ISMR-Labs/Sinhala-Speech-to-Haptic-System-for-the-Hearing-Impaired/media/README.md

# Media

## photos/2026-09-24-vibration-array

The first hardware build: 17 vibration-motor modules in printed pods on 1 m sleeved leads, the
push-button controller box, and the chase test with the ESP32-S3 lighting each module in turn.
EXIF removed, long edge 1600 px.

| | |
|---|---|
| `IMG_7158` | printed pods and lids fresh off the printer |
| `IMG_7161` to `IMG_7163` | the harness: 17 pods on braided leads |
| `IMG_7171` to `IMG_7178` | controller box with the push button, modules laid out |
| `IMG_7180` to `IMG_7184` | module close-ups and the full set |

## video

Videos are attached to the GitHub release `hardware-2026-09-24` to keep the repository small;
poster frames are kept here.

| File | Length | Contents |
|---|---|---|
| `vibration-array-demo-2026-09-24.mp4` | 24 s | chase test: modules buzzing one after another |
| `vibration-array-modules-2026-09-24.mp4` | 8 s | close-up of the pods and leads |
