ISMR-Labs/Sinhala-Speech-to-Haptic-System-for-the-Hearing-Impaired/paper/haptic-vest.pdf

# A Word-Level Vibrotactile Vest for Delivering Spoken Sinhala to Deaf Users: Design, Encoding and Evaluation Protocol

Dilan Perera
Intelligent Systems & Mechatronics Research Laboratory (ISMR Labs) Colombo, Sri Lanka
https://github.com/ISMR-Labs/Sinhala-Speech-to-Haptic-System-for-the-Hearing-Impaired

Abstract—About 390 000 Sri Lankans have a hearing difficulty, most of them in Sinhala-speaking households where no standardised sign language is shared with hearing family members. We describe a wearable system that lets a deaf person feel spoken Sinhala as vibration. A laptop recognises speech with a Sinhalatuned Whisper model and maps each recognised word of a closed vocabulary to a short vibrotactile pattern, which an ESP32-S3 controller plays on 18 coin-motor modules arranged as two 3×3 grids on the chest and upper back of a vest. Rather than coding phonemes, as recent tactile speech displays do, the system codes whole words as two 200 ms frames of one or two active motors, which keeps every pattern inside the 3 cm to 4 cm spatial acuity of the torso and gives a codebook whose minimum pairwise distance is two of three cues for a 20-word vocabulary. We present the hardware, the encoding and its justification from the vibrotactile literature, the host pipeline, and the protocol of a learnability study with hearing and deaf participants. The 17-module prototype, firmware, host software, codebook and study tools are released as an open repository. No perception results are reported yet; the paper documents the design and the evaluation plan.
Index Terms—vibrotactile display, sensory substitution, haptic communication, deaf, Sinhala, speech recognition, wearable, ESP32
I. INTRODUCTION

The 2012 census of Sri Lanka counted 389 077 persons with hearing difficulty, 21 per 1000 of the population [1]. Advocacy groups put the number of deaf and hard-of-hearing people at about 400 000 and the number of recognised signlanguage interpreters in the low tens; the Sinhala-speaking deaf community does not share a fully standardised sign language with the hearing people around it. In a typical household the hearing members speak Sinhala and the deaf member lip-reads, writes, or is left out.
Delivering speech through the skin has a long history. Geldard’s Vibratese used five chest vibrators with three durations and three intensities, and trained readers exceeded 35 words per minute [2]. Tactile aids of the 1980s and 1990s transmitted spectral features of speech as a supplement to lipreading, with mixed adoption [3]. The most complete recent system, TAPS, codes the 39 English phonemes as spatial and movement patterns on 24 forearm tactors; ten adults reached 86 % phoneme recognition after one to four hours of training [4], and the best learners acquired 500 words at about one word per minute [5]. Sound-to-touch devices for the deaf take a different route, mapping frequency bands of ambient sound to motors on the torso or wrist [6], [7]; they convey that a sound happened and its character, not its words.
None of these systems exists for Sinhala, and none fits the situation of a deaf family member who needs a small set of words reliably. Our design question is therefore narrow: can a low-cost vest with 18 vibration modules deliver a closed vocabulary of spoken Sinhala words that a wearer can learn in a few sessions and identify reliably? This paper gives the design and the plan to answer it.

II. RELATED WORK AND DESIGN CONSTRAINTS

Three results from the vibrotactile literature bound the design.
Spatial acuity on the torso. Van Erp measured 3 cm to 4 cm acuity for successive stimuli over most of the torso, with stimulus onset asynchrony as the main timing factor, and absolute localisation within about 5 cm [8], [9]. Jóhannesson et al. found relative acuity down to 13 mm spacing in a two-alternative task [10]. Localisation is best near anatomical landmarks such as the midline [11]. A 3 × 3 grid at 80 mm pitch, centred on the midline, is therefore conservative. Pattern recognition on the torso. Jones, Lockyer and Piateski report 99–100 % identification for seven of eight simple patterns on a torso array, better than on the forearm and unaffected by walking [12]. Simple spatial patterns on the torso are nearly error-free; complexity, not the site, is the limit.
Throughput. Novich and Eagleman estimated the achievable information rate of the skin with spatiotemporal codes on the back and concluded that it falls below the 64 bit/s to 110 bit/s that continuous speech requires [6]. Phoneme-level coding reaches practical word rates of about one per minute even after extended training [5].
Together these argue for word-level codes on a coarse torso grid: patterns the skin resolves without error, a vocabulary chosen for need rather than coverage, and no attempt at phoneme streams. Coin eccentric-rotating-mass (ERM) motors vibrate at 150 Hz to 200 Hz, on the sensitive part of the Pacinian channel that peaks near 250 Hz [13], and are cheap

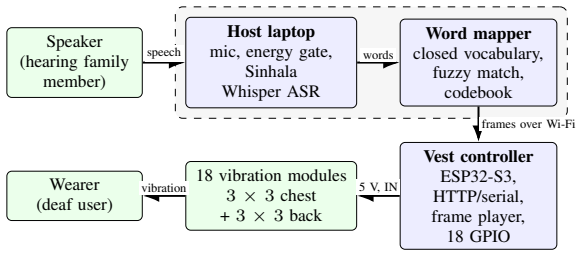
[picture p10: figure]
Speaker (hearing family member); Host laptop mic, energy gate, Sinhala Whisper ASR; Word mapper closed vocabulary, fuzzy match, codebook; Vest controller ESP32-S3, HTTP/serial, frame player, 18 GPIO; 18 vibration modules 3 × 3 chest + 3 × 3 back; Wearer (deaf user); speech; words; frames over Wi-Fi; vibration

Fig. 1. System overview. Speech recognition and word mapping run on the laptop; the vest controller only plays timed frames.


Fig. 2. Motor layout. F1–F9 on the chest, B1–B9 on the upper back, 80 mm pitch, centre column on the midline.

and robust; their 50 ms to 100 ms spin-up sets a lower bound on frame length.

III. SYSTEM DESIGN

A. Architecture

Fig. 1 shows the pipeline. Recognition and vocabulary mapping run on a laptop so that the model can be swapped without reflashing; the vest controller is deliberately simple and plays frame sequences with its own timing, so network jitter does not disturb the rhythm inside a word.

B. Vest hardware

The vest carries 18 three-pin vibration modules (coin ERM motor with an on-board switching transistor) in 3D-printed pods, nine on the chest and nine on the upper back, each 3 × 3 at 80 mm pitch (Fig. 2). Pods are held on a two-layer sports vest with hook-and-loop patches so that the pitch can be adjusted per wearer. Each module’s input is driven directly from a GPIO of an ESP32-S3 DevKitC; the 20 GPIOs used leave two spares. Modules share a 5 V rail from a USB power bank; the normal load is two motors per frame (160 mA), the chase test is the only time all 18 run. The controller, power lead and a push button sit in a printed box at the hip. Module leads are 1 m of three-core wire in 4 mm braided sleeving. All enclosures are OpenSCAD parts in the repository.

TABLE I
VOCABULARY V0: 20 WORDS CHOSEN FOR EVERYDAY EXCHANGES IN A HOUSEHOLD.
Category | Words (romanised)
Response | ow (yes) | naehae (no)
Command | enna (come) | yanna (go) | nawathwanna (stop)
| inna (wait)
Alert | udaw (help) | anathura (danger)
Social | ayubowan (hello) | sthuthiyi (thanks) | hondayi (good)
Need | kanna (eat) | bonna (drink) | wathura (water)
Person | amma (mother) | thaththa (father)
Question | koheda (where) | mokakda (what)
Time | daen (now) | passe (later)
C. Firmware
The controller accepts one text protocol over HTTP (port 80, mDNS vest.local) and over USB serial: a sequence of frames F <motors> <ms> <level> separated by semicolons, a gap setting, stop, chase test and status. Frames are timed with the millisecond clock and up to 32 are buffered. Level is a 100 Hz software PWM on the module input; with ERM motors it changes amplitude and frequency together, so the first vocabulary uses full level only. GPIO 3, 45 and 46 are strapping pins; the three-pin modules present a floating or weakly low input at reset, which was verified to boot normally.
D. Encoding
A word is two frames of 200 ms, separated by 80 ms, each frame switching on one motor or an adjacent horizontal or vertical pair on the same side of the body; words are separated by 400 ms. The frame length exceeds the ERM spin-up, the gap lets the motor stop so the second frame is a separate event, and the alphabet of 18 singles plus 24 pairs gives 42² = 1764 two-frame codes. Codes are assigned to words by a deterministic greedy search that maximises the minimum pairwise distance, defined as the sum over frame positions of the Jaccard distance between motor sets plus one when the front/back sequence differs; front-to-back movement is the easiest cue to feel. For the 20-word vocabulary in Table I the minimum distance is 2.0 of a possible 3.0: every pair of words differs in at least two of its three cues. Fig. 3 shows the first eight codes. Three reserved signals mark listening, an out-ofvocabulary word, and the end of an utterance.
E. Speech pipeline
The host captures the microphone at 16 kHz, cuts utterances with an energy gate (0.7 s of silence ends an utterance), and transcribes with faster-whisper, the CTranslate2 port of Whisper [14], with the language fixed to Sinhala. Whisper’s multilingual base models are weak on Sinhala, so the pipeline accepts any fine-tuned checkpoint; public fine-tunes trained on the crowd-sourced Sinhala corpus (about 185 000 utterances from 478 speakers [15], with the transcript refinements of [16]) report word error rates of about 22 % to 30 % on open text, and XLS-R fine-tunes [17] report 24 % to 37 %. The vest does not need open-text accuracy: the recogniser output is


Fig. 3. The first eight word codes. Each word is two frames of 200 ms; filled circles are active motors on the front and back 3 × 3 grids.

matched against the 20-word vocabulary in Sinhala script, with
a fuzzy match that tolerates a vowel-sign or final-letter error,
and anything else is signalled as unknown. Closed-vocabulary accuracy will be measured on recordings of the 20 words from ten speakers before the user study, and a small keywordspotting model is the fallback if it is insufficient.

IV. EVALUATION PROTOCOL

The primary question is learnability. A pilot with eight hearing lab members, wearing ear defenders and masked by pink noise so that the motors cannot be heard, validates the codebook and procedure. The main study recruits 10 to 12 deaf or hard-of-hearing adults who read Sinhala, through the Sri Lanka Central Federation of the Deaf, with consent and instructions in Sinhala and Sri Lankan Sign Language. Each participant completes three sessions on separate days: familiarisation (each word twice with its label), two training blocks of 60 trials with feedback, a 60-trial identification test without feedback, and in the last session ten two- and three-word sentences for free recall. Sessions two and three begin with the test, giving 24 and 48 h retention. Measures are identification accuracy, the learning curve, the 20 × 20 confusion matrix, reaction time and comfort. A word pair confused on more than 15 % of presentations is re-coded, accepted only if the minimum codebook distance does not fall. Success for this version is mean accuracy above 80 % at session three and no pair confused above 25 %. A second study will compare the distance-optimal codebook with a mnemonic one (for example come as back-to-front motion), which may trade geometric separation for faster learning.

V. STATUS

Seventeen modules, their pods and the controller box have been built and wired on 1 m leads; a chase test on the ESP32-S3 confirmed every module and the strapping-pin behaviour. The vest controller firmware compiles and implements the full protocol; the host tools play words and typed sentences on the hardware or on a terminal simulator, and run the microphone pipeline. The eighteenth module, the garment fitting, supply decoupling and the ASR closed-vocabulary test remain before the pilot. All design files, the codebook generator, the study protocol and the analysis script are in the repository.

VI. DISCUSSION AND LIMITATIONS
The design trades vocabulary size for reliability. Twenty words cover calls, warnings, basic needs and two names; the two-frame alphabet has room for perhaps 40 words before perceptual separation falls, and three frames, a second intensity level, or a category-prefix frame can extend it. Whether deaf users prefer the arbitrary distance-optimal codes or mnemonic codes is an empirical question the second study addresses. ERM motors couple amplitude and frequency and start slowly; linear resonant actuators with a dedicated driver would allow faster, more uniform frames and a usable intensity dimension. The speech front end is the weakest link: Sinhala ASR is a low-resource problem, and the vest is only as good as the recogniser’s accuracy on the vocabulary in a noisy home, which is why closed-vocabulary accuracy is measured first and keyword spotting is kept as a fallback. Finally, a torso display cannot replace sign language or captioning; its role is to let a deaf person receive a small set of important words from people who do not sign, in the moment, without looking.

VII. CONCLUSION
We have presented a low-cost vest that delivers spoken Sinhala words as vibration patterns on the torso, grounded in what the vibrotactile literature says the skin can resolve, together with firmware, host software, a 20-word codebook with guaranteed separation, and a study protocol. The next step is the learnability study, whose results will be added to the repository.

REFERENCES

[1] Department of Census and Statistics, Sri Lanka, “Census of population and housing 2012: Disability tables,” Department of Census and Statistics, Colombo, Tech. Rep., 2012.
[2] F. A. Geldard, “Adventures in tactile literacy,” American Psychologist, vol. 12, no. 3, pp. 115–124, 1957.
[3] I. R. Summers, Ed., Tactile Aids for the Hearing Impaired. London: Whurr, 1992.
[4] C. M. Reed, H. Z. Tan, Z. D. Perez, E. C. Wilson, F. M. Severgnini,
J. Jung, J. S. Martinez, Y. Jiao, A. Israr, F. Lau, K. Klumb, R. Turcott, and F. Abnousi, “A phonemic-based tactile display for speech communication,” IEEE Transactions on Haptics, vol. 12, no. 1, pp. 2–17, 2019.

[5] H. Z. Tan, C. M. Reed, Y. Jiao, Z. D. Perez, E. C. Wilson, J. Jung,
J. S. Martinez, and F. M. Severgnini, “Acquisition of 500 English words through a TActile Phonemic Sleeve (TAPS),” IEEE Transactions on Haptics, vol. 13, no. 4, pp. 745–760, 2020.
[6] S. D. Novich and D. M. Eagleman, “Using space and time to encode vibrotactile information: toward an estimate of the skin’s achievable throughput,” Experimental Brain Research, vol. 233, no. 10, pp. 2777– 2788, 2015.
[7] M. V. Perrotta, T. Asgeirsdottir, and D. M. Eagleman, “Deciphering sounds through patterns of vibration on the skin,” Neuroscience, vol. 458, pp. 77–86, 2021.
[8] J. B. F. van Erp, “Vibrotactile spatial acuity on the torso: effects of location and timing parameters,” in Proc. First Joint Eurohaptics Conference and Symposium on Haptic Interfaces for Virtual Environment and Teleoperator Systems (WHC 2005), 2005, pp. 80–85.
[9] ——, “Presenting directions with a vibrotactile torso display,” Ergonomics, vol. 48, no. 3, pp. 302–313, 2005.
[10] Ó. I. Jóhannesson, R. Hoffmann, V. V. Valgeirsdóttir, R. Unnþórsson,
A. Moldoveanu, and Á. Kristjánsson, “Relative vibrotactile spatial acuity of the torso,” Experimental Brain Research, vol. 235, pp. 3505–3515, 2017.
[11] R. W. Cholewiak, J. C. Brill, and A. Schwab, “Vibrotactile localization on the abdomen: effects of place and space,” Perception & Psychophysics, vol. 66, no. 6, pp. 970–987, 2004.
[12] L. A. Jones, B. Lockyer, and E. Piateski, “Tactile display and vibrotactile pattern recognition on the torso,” Advanced Robotics, vol. 20, no. 12, pp. 1359–1374, 2006.
[13] J. C. Makous, R. M. Friedman, and C. J. Vierck, “A critical band filter in touch,” Journal of Neuroscience, vol. 15, no. 4, pp. 2808–2818, 1995.
[14] A. Radford, J. W. Kim, T. Xu, G. Brockman, C. McLeavey, and
I. Sutskever, “Robust speech recognition via large-scale weak supervision,” in Proc. 40th International Conference on Machine Learning (ICML 2023), ser. PMLR, vol. 202, 2023, pp. 28 492–28 518.
[15] O. Kjartansson, S. Sarin, K. Pipatsrisawat, M. Jansche, and L. Ha, “Crowd-sourced speech corpora for Javanese, Sundanese, Sinhala, Nepali, and Bangladeshi Bengali,” in Proc. 6th Workshop on Spoken Language Technologies for Under-Resourced Languages (SLTU 2018), 2018, pp. 52–55.
[16] D. Warusawithana, N. Kulaweera, L. Weerasinghe, and B. Karunarathne, “A systematic approach to derive a refined speech corpus for Sinhala,” in Proc. 13th Language Resources and Evaluation Conference (LREC 2022), Marseille, France, 2022, pp. 5107–5113.
[17] A. Babu, C. Wang, A. Tjandra, K. Lakhotia, Q. Xu, N. Goyal, K. Singh,
P. von Platen, Y. Saraf, J. Pino, A. Baevski, A. Conneau, and M. Auli, “XLS-R: self-supervised cross-lingual speech representation learning at scale,” in Proc. Interspeech 2022, 2022, pp. 2278–2282.
