ISMR-Labs/Sinhala-Speech-to-Haptic-System-for-the-Hearing-Impaired/docs/figures/mannequin.png

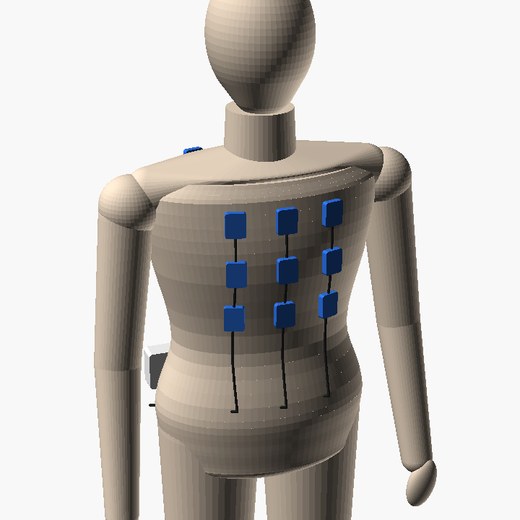
docs/figures/mannequin.png
