ISMR-Labs/Sinhala-Speech-to-Haptic-System-for-the-Hearing-Impaired/docs/figures/patterns-all.png

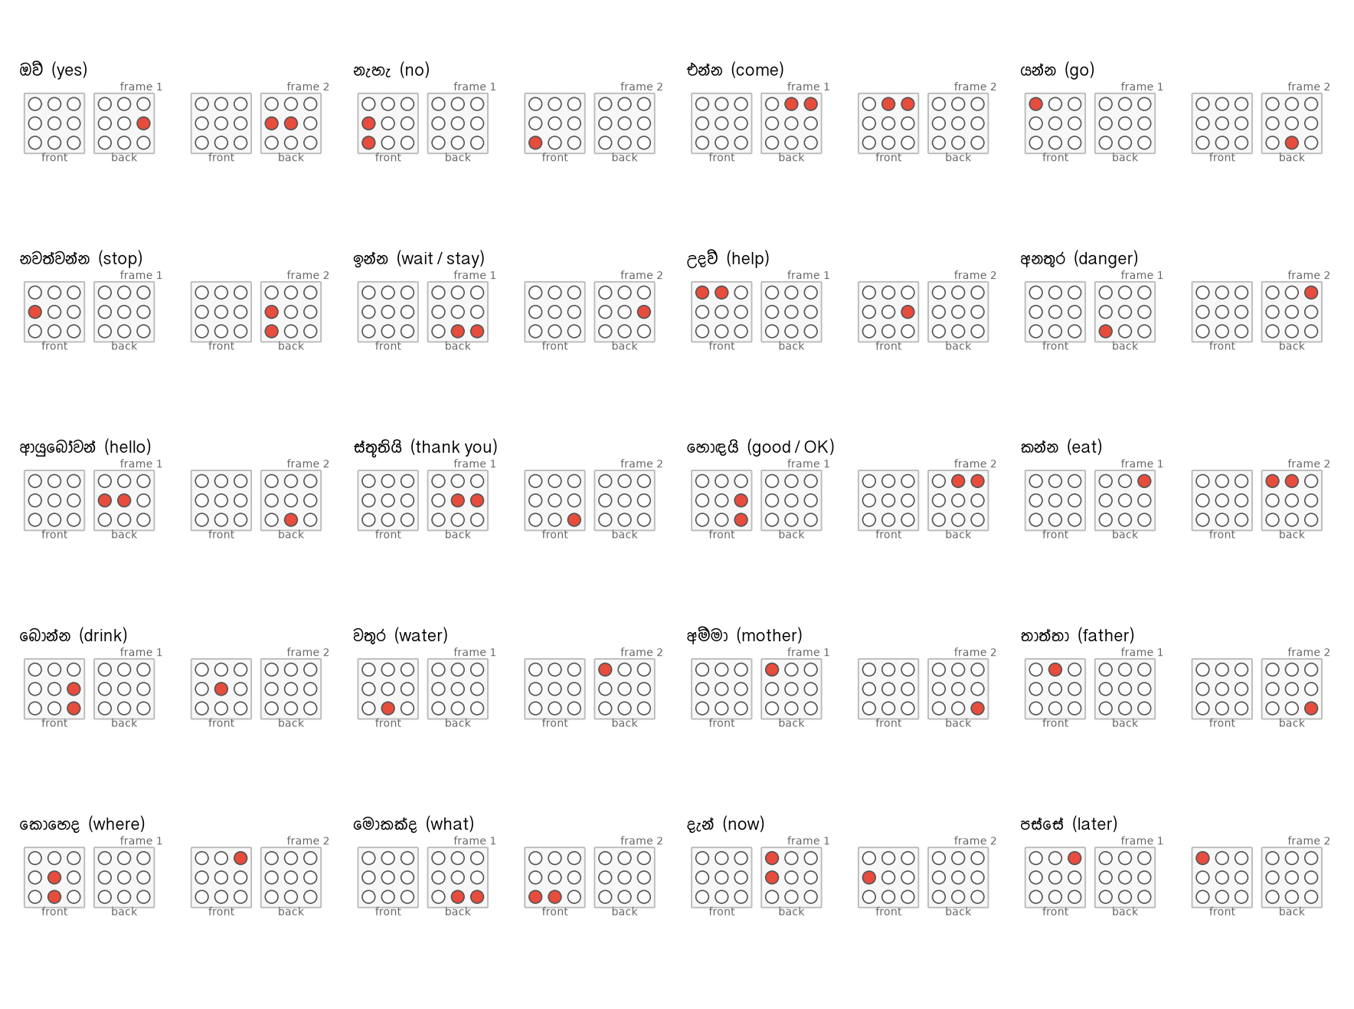
docs/figures/patterns-all.png
