ISMR-Labs/Sinhala-Speech-to-Haptic-System-for-the-Hearing-Impaired/hardware/enclosures/controller-box/controller-box.stl

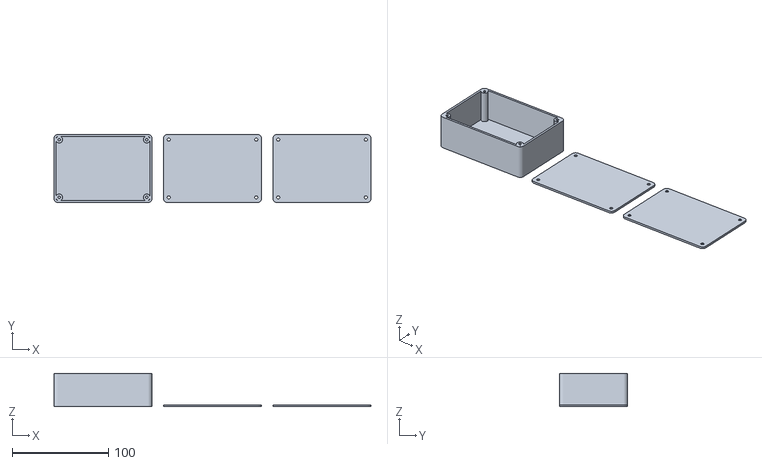
[picture p13: CAD file, 2026-10-10]
hardware/enclosures/controller-box/controller-box.stl
329.4 x 70.8 x 34.7
