ISMR-Labs/Sinhala-Speech-to-Haptic-System-for-the-Hearing-Impaired/(list of files, cad)

Other CAD files:
hardware/enclosures/controller-box/controller-box.scad
hardware/enclosures/vibration-motor-enclosure/vibration-motor-enclosure.scad
