ISMR-Labs/Sinhala-Speech-to-Haptic-System-for-the-Hearing-Impaired/(commit log)

2026-10-10 Design, encoding, firmware, host tools, study protocol and paper
    - 18-motor vest design: wiring, BOM, printed enclosures (SCAD/STL/renders/G-code)
    - word-level vibrotactile encoding v0 and a 20-word Sinhala codebook (min distance 2.0)
    - ESP32-S3 vest controller firmware (HTTP + serial frame player) and the bring-up chase sketch
    - host: Sinhala ASR (faster-whisper), vocabulary mapper, HTTP/serial/simulator transports
    - user study protocol and analysis script
    - IEEE-style paper with 17 references, annotated literature list, build log
    - photos of the September 2026 17-module prototype
    [controller-box.scad, controller-box.stl, vibration-motor-enclosure.scad, vibration-motor-enclosure.stl]
2026-10-11 Mannequin placement model and turntable animation
    OpenSCAD mannequin with the 18 pods on exact torso radii, sleeved leads to a
    lower-back controller box; tools/render_mannequin.py renders a 36-frame GIF
    that now leads the README.
    [mannequin.scad]
2026-10-11 More anatomical mannequin (smooth torso profile, shoulders, jaw); square same-size header images
    [mannequin.scad]
